ReviloG/Mind-Controller/README.md

# Mind-Controller
EEG-Arduino interface code
