ReviloG/Mind-Controller/Hardware Files/R1_01/PCB_Bottom.png

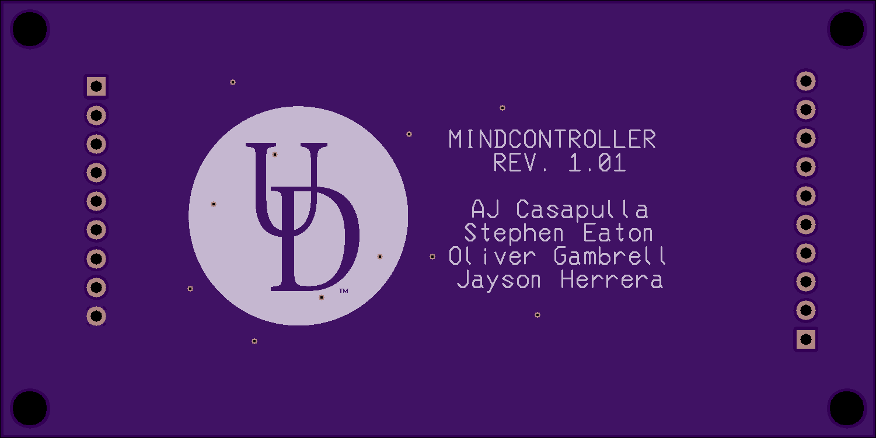
Hardware Files/R1_01/PCB_Bottom.png
