ReviloG/Mind-Controller/Hardware Files/R1_01/PCB_Top.png

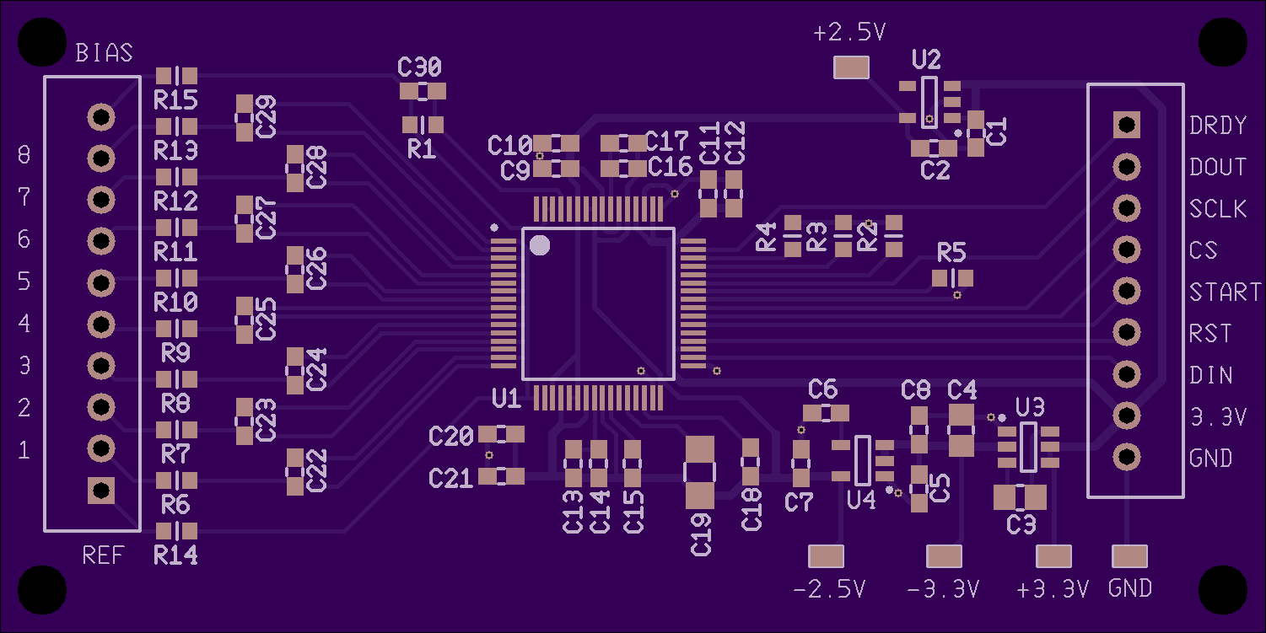
Hardware Files/R1_01/PCB_Top.png
