ReviloG/Mind-Controller/Hardware Files/MindController BOM.xlsx

Qty | MPN | Desc | Package | Cost |  | Ref Des | Link
1 | ADS1299 | Analog Front End | 64-TQFP | $53.84 | $53.84 | U1 | https://www.digikey.com/product-detail/en/texas-instruments/ADS1299IPAGR/296-34818-1-ND/3536905
1 | MIC5504-2.5 | Linear Regulator, 2.5V | SOT-23-5 | $0.11 | $0.11 |  | https://www.digikey.com/product-detail/en/microchip-technology/MIC5504-2.5YM5-TR/576-4880-1-ND/5209408
1 | LM2664M6X | Voltage Inverter | SOT-23-6 | $0.89 | $0.89 |  | https://www.digikey.com/product-detail/en/texas-instruments/LM2664M6X-NOPB/LM2664M6X-NOPBCT-ND/3527189
1 | TPS72325DBVR | Linear Regulator, -2.5V | SOT-23-5 | $2.81 | $2.81 |  | https://www.digikey.com/product-detail/en/texas-instruments/TPS72325DBVR/296-39479-1-ND/5143427
5 |  | SMT Test Point, 2.00x1.20mm |  | $0.24 | $1.20 |  | https://www.digikey.com/product-detail/en/te-connectivity-amp-connectors/RCT-0C/A106144CT-ND/3477801
6 |  | 0.1uF Capacitor | 603 | $0.10 | $0.60 |  | https://www.digikey.com/product-detail/en/yageo/CC0603KPX7R7BB104/311-1335-1-ND/2103119
9 |  | 1uF Capacitor | 603 | $0.10 | $0.90 |  | https://www.digikey.com/product-detail/en/kemet/C0603C105K8RACTU/399-11133-1-ND/4357815
2 |  | 10uF Capacitor | 805 | $0.23 | $0.46 |  | https://www.digikey.com/product-detail/en/samsung-electro-mechanics/CL21B106KQQNNNG/1276-6474-1-ND/5958102
1 |  | 100uF Cap | 1206 | $0.58 | $0.58 |  | https://www.digikey.com/product-detail/en/samsung-electro-mechanics/CL31A107MQHNNNE/1276-1782-1-ND/3889868
2 |  | 10nF Cap | 603 | $0.10 | $0.20 |  | https://www.digikey.com/product-detail/en/yageo/CC0603KPX7R9BB103/311-1572-1-ND/4340579
2 |  | 2.2uF Cap | 603 | $0.13 | $0.26 |  | https://www.digikey.com/product-detail/en/samsung-electro-mechanics/CL10B225KQ8NFNC/1276-2017-1-ND/3890103
8 |  | 4.7nF Cap | 603 | $0.10 | $0.80 |  | https://www.digikey.com/product-detail/en/yageo/CC0603KRX7R9BB473/311-1427-1-ND/2833733
4 |  | 10k Res | 603 | $0.10 | $0.40 |  | https://www.digikey.com/product-detail/en/yageo/RC0603FR-0710KL/311-10.0KHRCT-ND/729827
1 |  | 392k Res | 603 | $0.10 | $0.10 |  | https://www.digikey.com/product-detail/en/yageo/RC0603FR-07392KL/311-392KHRCT-ND/730148
10 |  | 4.99k Res | 603 | $0.10 | $1.00 |  | https://www.digikey.com/product-detail/en/yageo/RC0603FR-074K99L/311-4.99KHRCT-ND/730166
 |  |  |  |  | $64.15
