ReviloG/Mind-Controller/Copy of top.STL

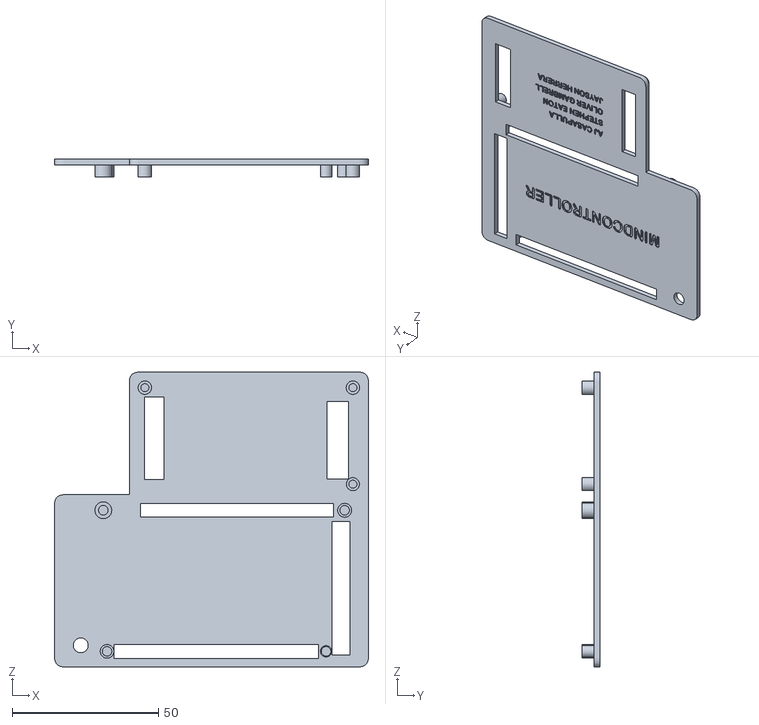
[picture p29: CAD file, 2020-05-20]
Copy of top.STL
107.4 x 6.00 x 100.9
