ReviloG/Mind-Controller/Arduino Case (1).STL

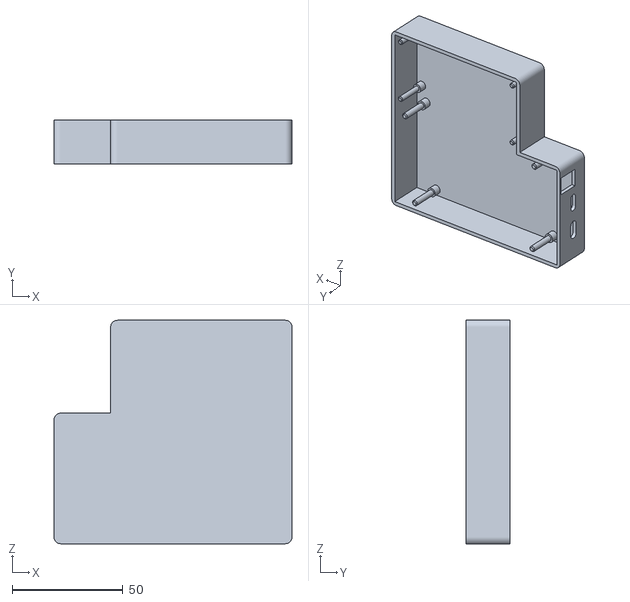
[picture p30: CAD file, 2020-05-20]
Arduino Case (1).STL
107.4 x 20.0 x 100.9
