ReviloG/Mind-Controller/(list of files, drawings)

Other design files:
Hardware Files/MindController ADS1299.ms14
