ReviloG/Mind-Controller/(commit log)

2020-04-26 Initial MCU-Mindcontroller Communications
    Used a NodeMCU that I had on hand since I don't have the Arduino Due. Current version only reads in the ID register from the ADS1299.
2020-05-09 Update
    Now reads a blank signal for 5sec, then the onboard square wave for 5sec, then reads from the attached probes. Currently only configured to read from probe 1.
